zhiyb/fpga/README.md

# fpga
FPGA (DE0-Nano) attachment PCB designs for fun
