zhiyb/fpga/pcb_io/fpga_io.kicad_pcb

## KiCad design pcb_io/fpga_io.kicad_pcb (2024-09-13)

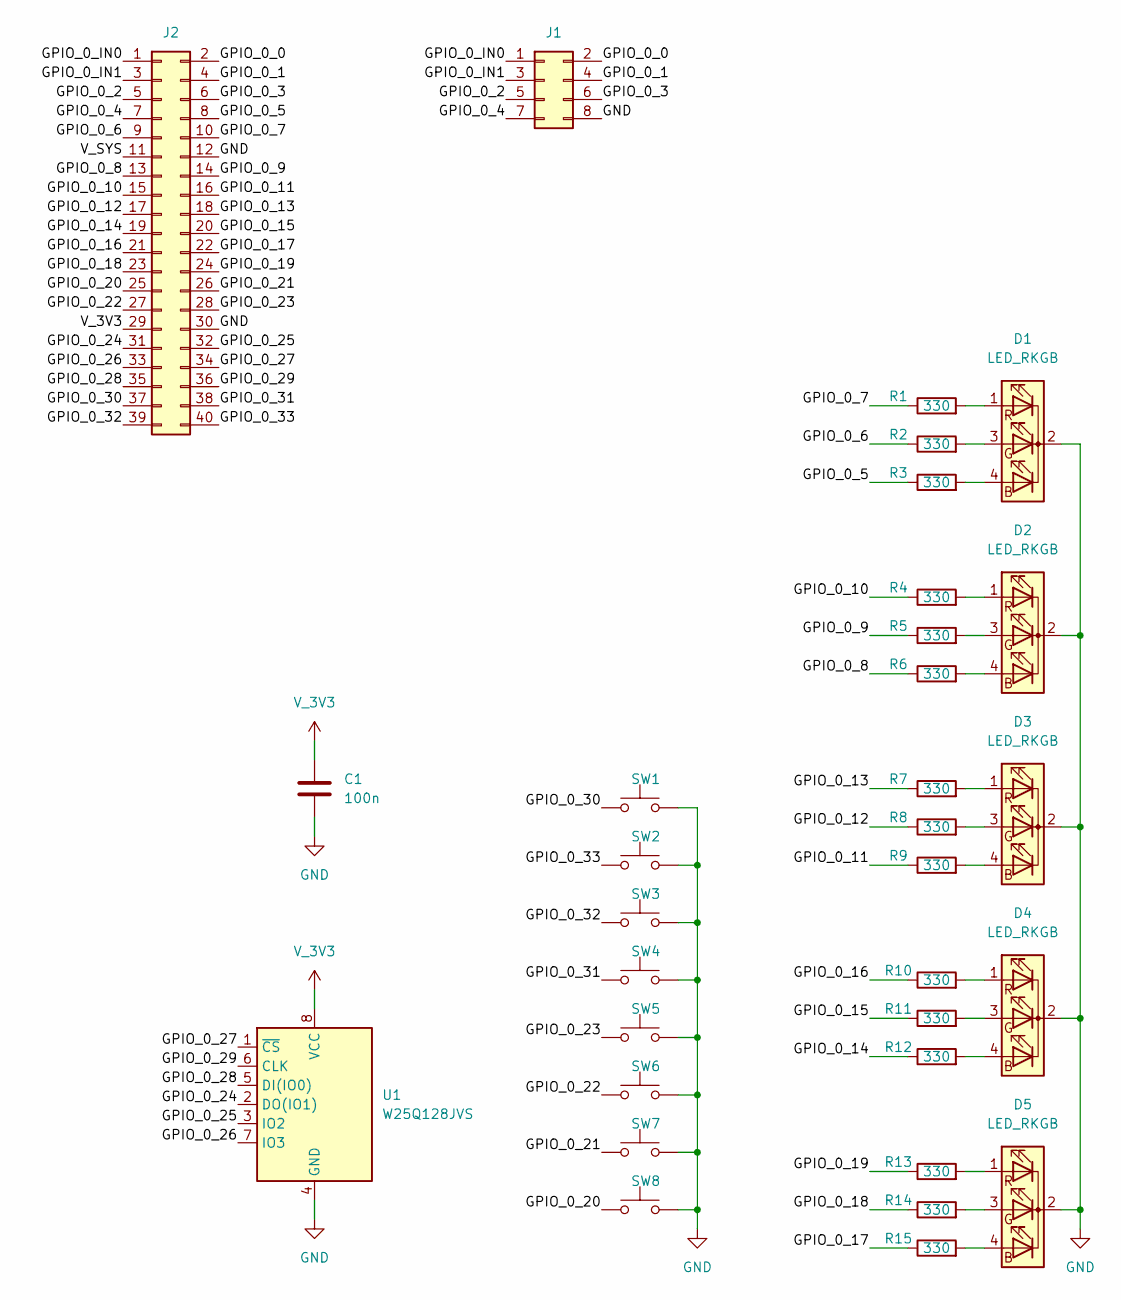
[picture p1: schematic fpga_io.kicad_sch, FPGA IO board]

Parts:
C1: 100n; C_0603_1608Metric
D1, D2, D3, D4, D5: LED_RKGB; LED_D5.0mm-4_RGB
J1: Conn_02x04_Odd_Even; PinHeader_2x04_P2.54mm_Vertical
J2: Conn_02x20_Odd_Even; PinSocket_2x20_P2.54mm_Vertical
R1, R2, R3, R4, R5, R6, R7, R8, R9, R10, R11, R12, R13, R14, R15: 330; R_0805_2012Metric
SW1, SW2, SW3, SW4, SW5, SW6, SW7, SW8: SW_Push; SW_Push_1P1T_NO_6x6mm_H9.5mm
U1: W25Q128JVS; SOIC-8_5.23x5.23mm_P1.27mm

Connections:
/GPIO_0_0: J1.2, J2.2
/GPIO_0_1: J1.4, J2.4
/GPIO_0_2: J1.5, J2.5
/GPIO_0_3: J1.6, J2.6
/GPIO_0_4: J1.7, J2.7
/GPIO_0_5: J2.8, R3.1
/GPIO_0_6: J2.9, R2.1
/GPIO_0_7: J2.10, R1.1
/GPIO_0_8: J2.13, R6.1
/GPIO_0_9: J2.14, R5.1
/GPIO_0_10: J2.15, R4.1
/GPIO_0_11: J2.16, R9.1
/GPIO_0_12: J2.17, R8.1
/GPIO_0_13: J2.18, R7.1
/GPIO_0_14: J2.19, R12.1
/GPIO_0_15: J2.20, R11.1
/GPIO_0_16: J2.21, R10.1
/GPIO_0_17: J2.22, R15.1
/GPIO_0_18: J2.23, R14.1
/GPIO_0_19: J2.24, R13.1
/GPIO_0_20: J2.25, SW8.1
/GPIO_0_21: J2.26, SW7.1
/GPIO_0_22: J2.27, SW6.1
/GPIO_0_23: J2.28, SW5.1
/GPIO_0_24: J2.31, U1.2 (DO(IO1))
/GPIO_0_25: J2.32, U1.3 (IO2)
/GPIO_0_26: J2.33, U1.7 (IO3)
/GPIO_0_27: J2.34, U1.1 (~CS)
/GPIO_0_28: J2.35, U1.5 (DI(IO0))
/GPIO_0_29: J2.36, U1.6 (CLK)
/GPIO_0_30: J2.37, SW1.1
/GPIO_0_31: J2.38, SW4.1
/GPIO_0_32: J2.39, SW3.1
/GPIO_0_33: J2.40, SW2.1
/GPIO_0_IN0: J1.1, J2.1
/GPIO_0_IN1: J1.3, J2.3
/V_SYS: J2.11
GND: C1.2, D1.2 (K), D2.2 (K), D3.2 (K), D4.2 (K), D5.2 (K), J1.8, J2.12, J2.30, SW1.2, SW2.2, SW3.2, SW4.2, SW5.2, SW6.2, SW7.2, SW8.2, U1.4 (GND)
unnamed: D1.4 (BA), R3.2
unnamed: D1.3 (GA), R2.2
unnamed: D1.1 (RA), R1.2
unnamed: D2.4 (BA), R6.2
unnamed: D2.3 (GA), R5.2
unnamed: D2.1 (RA), R4.2
unnamed: D3.4 (BA), R9.2
unnamed: D3.3 (GA), R8.2
unnamed: D3.1 (RA), R7.2
unnamed: D4.4 (BA), R12.2
unnamed: D4.3 (GA), R11.2
unnamed: D4.1 (RA), R10.2
unnamed: D5.4 (BA), R15.2
unnamed: D5.3 (GA), R14.2
unnamed: D5.1 (RA), R13.2
V_3V3: C1.1, J2.29, U1.8 (VCC)

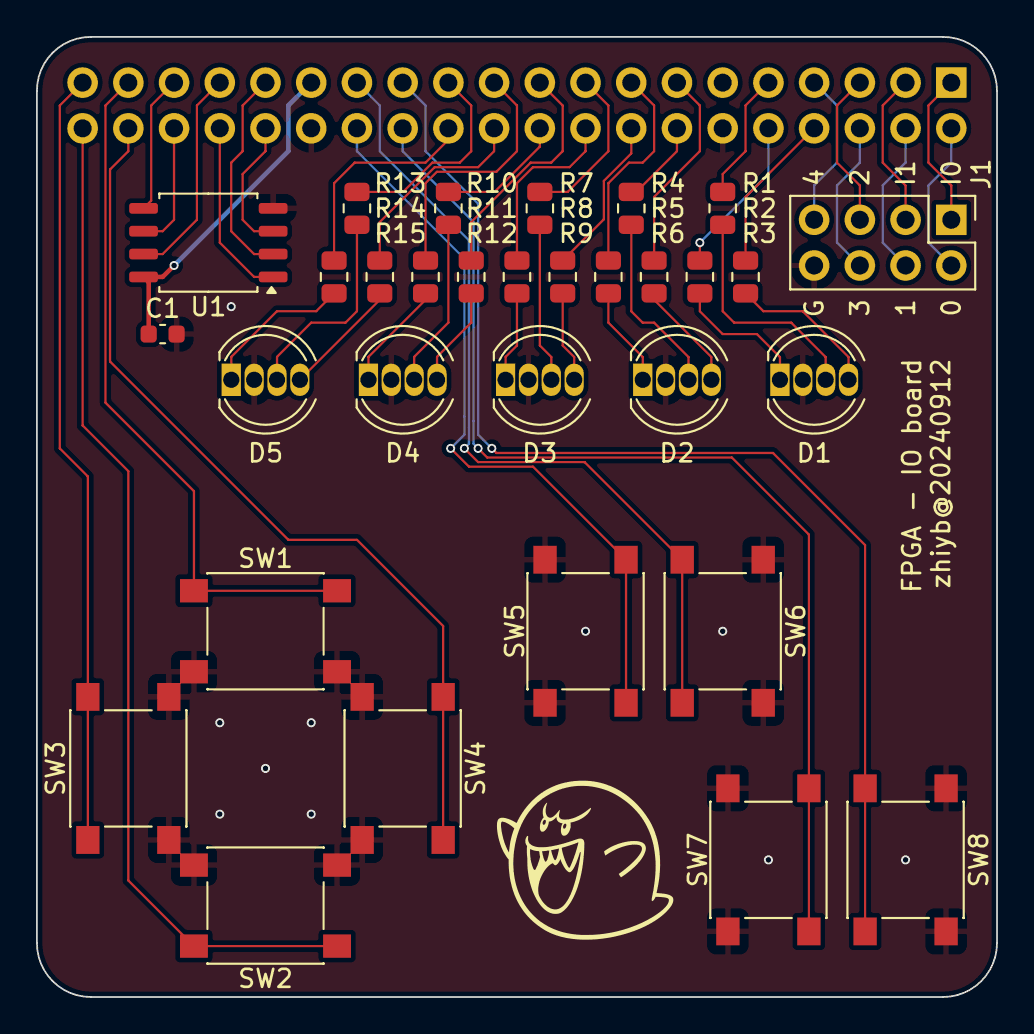
[picture p2: board fpga_io.kicad_pcb from above]

Board: 2 copper layers, 53.3 x 53.3 mm, 32 parts (1 on the bottom side), 53 nets.
