zhiyb/fpga/pcb_disp/fpga_disp.kicad_pcb

## KiCad design pcb_disp/fpga_disp.kicad_pcb (2024-09-13)

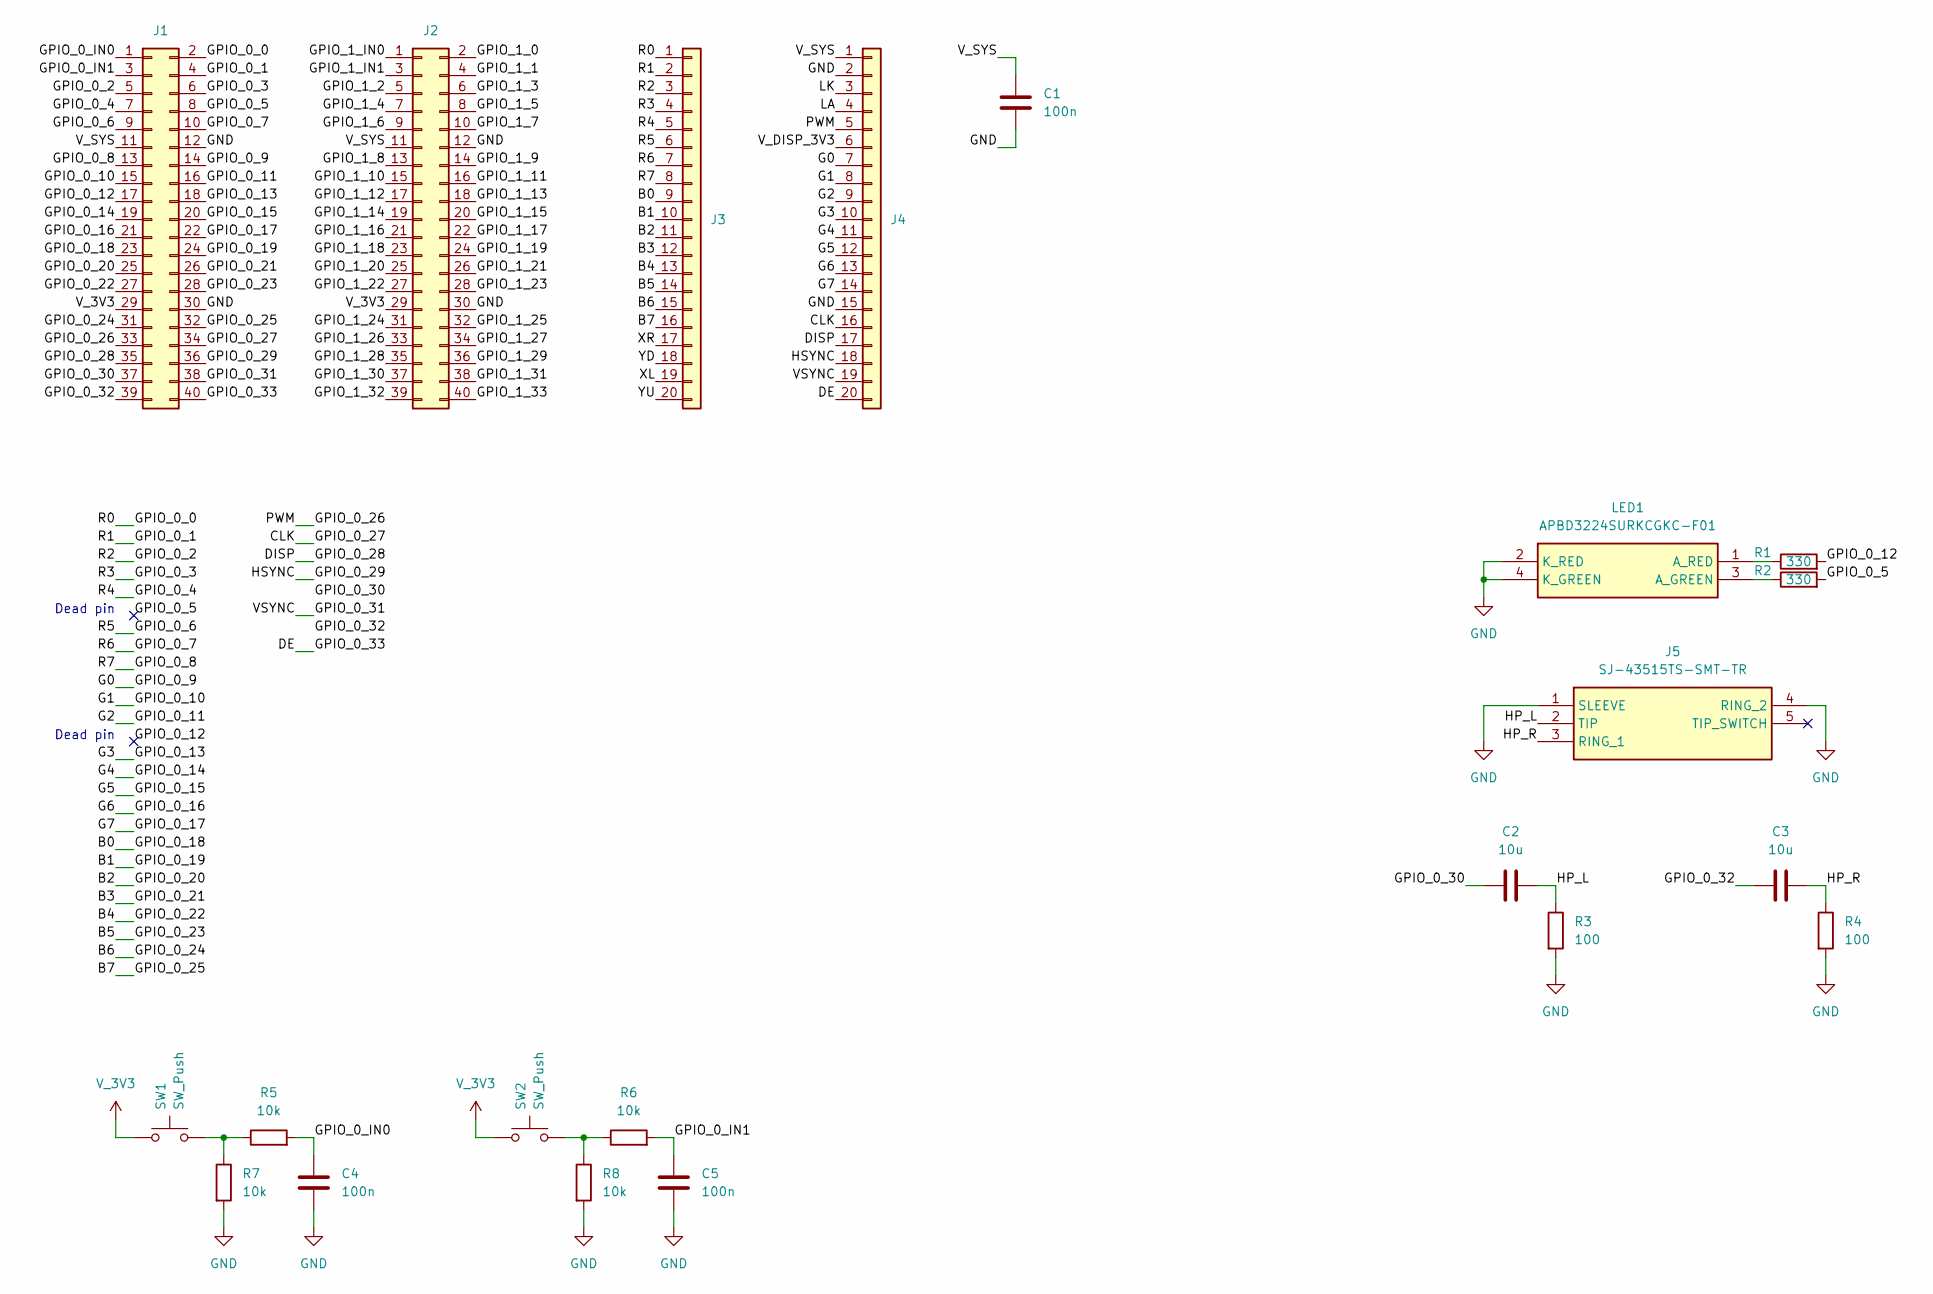
[picture p3: schematic fpga_disp.kicad_sch, FPGA display board]

Parts:
C1, C4, C5: 100n; C_0603_1608Metric
C2, C3: 10u; C_0805_2012Metric
J1, J2: Conn_02x20_Odd_Even; PinSocket_2x20_P2.54mm_Vertical
J3, J4: Conn_01x20; PinHeader_1x20_P2.54mm_Vertical
J5: SJ-43515TS-SMT-TR; SJ43515TSSMTTR; Mouser Part Number 490-SJ43515TS-SMT-TR
LED1: APBD3224SURKCGKC-F01; APBD3224SURKCGKCF01; Mouser Part Number 604-APBD3224SURKCGKC
R1, R2: 330; R_0805_2012Metric
R3, R4: 100; R_0805_2012Metric
R5, R6, R7, R8: 10k; R_0805_2012Metric
SW1, SW2: SW_Push; SW_Push_1P1T_NO_6x6mm_H9.5mm

Connections:
/B0: J1.23, J3.9
/B1: J1.24, J3.10
/B2: J1.25, J3.11
/B3: J1.26, J3.12
/B4: J1.27, J3.13
/B5: J1.28, J3.14
/B6: J1.31, J3.15
/B7: J1.32, J3.16
/CLK: J1.34, J4.16
/DE: J1.40, J4.20
/DISP: J1.35, J4.17
/G0: J1.14, J4.7
/G1: J1.15, J4.8
/G2: J1.16, J4.9
/G3: J1.18, J4.10
/G4: J1.19, J4.11
/G5: J1.20, J4.12
/G6: J1.21, J4.13
/G7: J1.22, J4.14
/GPIO_0_0: J1.2, J3.1
/GPIO_0_1: J1.4, J3.2
/GPIO_0_2: J1.5, J3.3
/GPIO_0_3: J1.6, J3.4
/GPIO_0_4: J1.7, J3.5
/GPIO_0_5: J1.8, R2.2
/GPIO_0_6: J1.9, J3.6
/GPIO_0_7: J1.10, J3.7
/GPIO_0_8: J1.13, J3.8
/GPIO_0_12: J1.17, R1.2
/GPIO_0_26: J1.33, J4.5
/GPIO_0_29: J1.36, J4.18
/GPIO_0_30: C2.1, J1.37
/GPIO_0_31: J1.38, J4.19
/GPIO_0_32: C3.1, J1.39
/GPIO_0_IN0: C4.1, J1.1, R5.2
/GPIO_0_IN1: C5.1, J1.3, R6.2
/HP_L: C2.2, J5.2 (TIP), R3.1
/HP_R: C3.2, J5.3 (RING_1), R4.1
/LA: J4.4
/LK: J4.3
/V_DISP_3V3: J4.6
/V_SYS: C1.1, J1.11, J2.11, J4.1
/XL: J3.19
/XR: J3.17
/YD: J3.18
/YU: J3.20
GND: C1.2, C4.2, C5.2, J1.12, J1.30, J2.12, J2.30, J4.2, J4.15, J5.1 (SLEEVE), J5.4 (RING_2), LED1.2 (K_RED), LED1.4 (K_GREEN), R3.2, R4.2, R7.2, R8.2
unnamed: LED1.3 (A_GREEN), R2.1
unnamed: LED1.1 (A_RED), R1.1
unnamed: R5.1, R7.1, SW1.2
unnamed: R6.1, R8.1, SW2.2
V_3V3: J1.29, J2.29, SW1.1, SW2.1

Notes on the sheet:
Dead pin

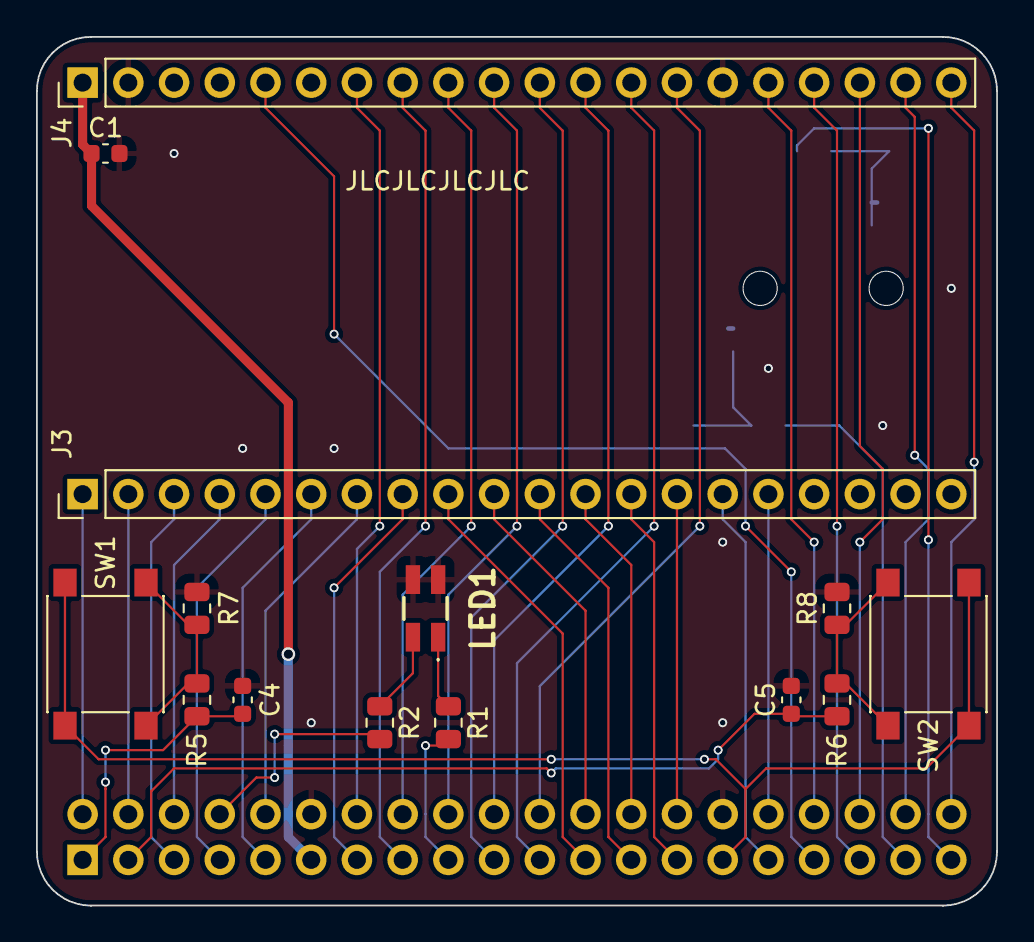
[picture p4: board fpga_disp.kicad_pcb from above]

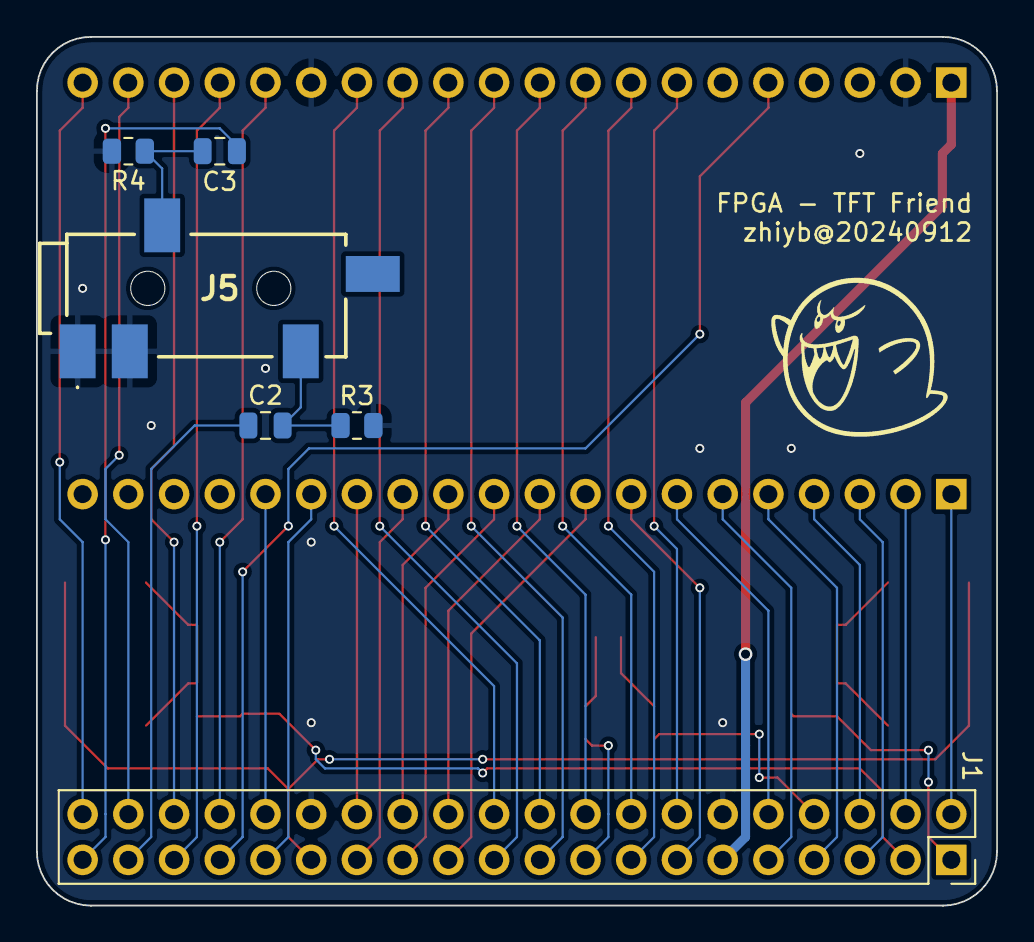
[picture p5: board fpga_disp.kicad_pcb from below]

Board: 2 copper layers, 53.3 x 48.3 mm, 20 parts (6 on the bottom side), 45 nets.
