zhiyb/fpga/(commit log)

2024-09-13 pcb_disp: Version 20240912
    [avr.kicad_sch, esp8266.kicad_sch, fpga_disp.kicad_pcb, fpga_disp.kicad_sch, pmic.kicad_sch, rpi_pico.kicad_sch, stm32.kicad_sch, stm32f7.kicad_sch]
2024-09-13 pcb_io: Version 20240912
    [avr.kicad_sch, esp8266.kicad_sch, fpga_io.kicad_pcb, fpga_io.kicad_sch, pmic.kicad_sch, rpi_pico.kicad_sch, stm32.kicad_sch, stm32f7.kicad_sch]
